martinch14/tecsci_spincoater_hardware_kicad/BOM_listado_Digi_Final.xlsx

Index | Quantity | Part Number | Manufacturer Part Number | Description | Customer Reference | Available | Backorder | Unit Price | Extended Price USD
1 | 1 | 732-5317-ND | 61300411121 | CONN HEADER VERT 4POS 2.54MM |  | 1 | 0 | 0.18 | 0.18
2 | 11 | P10.0KHCT-ND | ERJ-3EKF1002V | RES SMD 10K OHM 1% 1/10W 0603 |  | 11 | 0 | 0.042 | 0.46
3 | 3 | 2N7002NCT-ND | 2N7002 | MOSFET N-CH 60V 115MA SOT-23 |  | 3 | 0 | 0.32 | 0.96
4 | 1 | 1904-1025-1-ND | ESP32-WROOM-32D (16MB) | RX TXRX MOD WIFI TRACE ANT SMD |  | 1 | 0 | 4.5 | 4.50
5 | 1 | SMBJ33A-E3/52GICT-ND | SMBJ33A-E3/52 | TVS DIODE 33V 53.3V DO214AA |  | 1 | 0 | 0.47 | 0.47
6 | 2 | MMSS8050-H-TPMSCT-ND | MMSS8050-H-TP | TRANS NPN 25V 1.5A SOT23 |  | 2 | 0 | 0.18 | 0.36
7 | 1 | 1253-1767-1-ND | MC2016K25.0000C16ESH | XTAL OSC XO 25.0000MHZ CMOS SMD |  | 1 | 0 | 2.37 | 2.37
8 | 1 | 296-47335-1-ND | LMR16020PDDAR | IC REG BUCK ADJUSTABLE 2A 8SOPWR |  | 1 | 0 | 3.38 | 3.38
9 | 1 | 160-2212-1-ND | LTST-C191TBKT-5A | LED BLUE CLEAR CHIP SMD |  | 1 | 0 | 0.48 | 0.48
10 | 2 | AD8418WBRZ-RLCT-ND | AD8418WBRZ-RL | IC CURR SENSE 1 CIRCUIT 8SOIC |  | 2 | 0 | 2.73 | 5.46
11 | 1 | 1460-TMC6100-LA-TCT-ND | TMC6100-LA-T | GATE DRIVER IC 8-60V QFN37 |  | 1 | 0 | 3.13 | 3.13
12 | 2 | 1727-7043-1-ND | 74LVC3G17DC,125 | IC BUF NON-INVERT 5.5V 8VSSOP |  | 2 | 0 | 0.63 | 1.26
13 | 1 | 1460-TMC4671-LA-ND | TMC4671-LA | SERVO CONTROLLER IC, QFN76 |  | 0 | 1 | 12.01 | 12.01
14 | 1 | 336-5890-1-ND | CP2102N-A02-GQFN28R | IC USB TO UART BRIDGE QFN28 |  | 1 | 0 | 1.4 | 1.40
15 | 2 | 401-1704-1-ND | KSR223GLFG | SWITCH TACTILE SPST-NO 0.01A 32V |  | 2 | 0 | 0.84 | 1.68
16 | 1 | P33.0KHCT-ND | ERJ-3EKF3302V | RES SMD 33K OHM 1% 1/10W 0603 |  | 1 | 0 | 0.1 | 0.10
17 | 1 | P270KHCT-ND | ERJ-3EKF2703V | RES SMD 270K OHM 1% 1/10W 0603 |  | 1 | 0 | 0.1 | 0.10
18 | 1 | P47.0KHCT-ND | ERJ-3EKF4702V | RES SMD 47K OHM 1% 1/10W 0603 |  | 1 | 0 | 0.1 | 0.10
19 | 1 | P220KHCT-ND | ERJ-3EKF2203V | RES SMD 220K OHM 1% 1/10W 0603 |  | 1 | 0 | 0.1 | 0.10
20 | 2 | CRE2512-FZ-R005E-3CT-ND | CRE2512-FZ-R005E-3 | RES 0.005 OHM 1% 3W 2512 |  | 2 | 0 | 0.74 | 1.48
21 | 12 | P4.70KHCT-ND | ERJ-3EKF4701V | RES SMD 4.7K OHM 1% 1/10W 0603 |  | 12 | 0 | 0.049 | 0.59
22 | 2 | 311-1.0KARCT-ND | RC0805JR-071KL | RES SMD 1K OHM 5% 1/8W 0805 |  | 2 | 0 | 0.1 | 0.20
23 | 2 | P10KACT-ND | ERJ-6GEYJ103V | RES SMD 10K OHM 5% 1/8W 0805 |  | 2 | 0 | 0.1 | 0.20
24 | 1 | 1276-5544-1-ND | RC2012J472CS | RES SMD 4.7K OHM 5% 1/8W 0805 |  | 1 | 0 | 0.14 | 0.14
25 | 3 | SI7938DP-T1-GE3CT-ND | SI7938DP-T1-GE3 | MOSFET 2N-CH 40V 60A PPAK SO-8 |  | 3 | 0 | 1.48 | 4.44
26 | 2 | 732-1593-1-ND | 742792651 | FERRITE BEAD 600 OHM 0603 1LN |  | 2 | 0 | 0.17 | 0.34
27 | 1 | 445-173041-1-ND | VLS6045EX-150M | FIXED IND 15UH 2.5A 98 MOHM SMD |  | 1 | 0 | 0.51 | 0.51
28 | 3 | 490-13269-1-ND | BLM31SN500SN1L | FERRITE BEAD 50 OHM 1206 1LN |  | 3 | 0 | 0.35 | 1.05
29 | 1 | 277-1106-ND | 1757242 | TERM BLOCK HDR 2POS 90DEG 5.08MM |  | 1 | 0 | 0.64 | 0.64
30 | 1 | 277-1207-ND | 1803280 | TERM BLOCK HDR 3POS 90DEG 3.81MM |  | 1 | 0 | 1.26 | 1.26
31 | 2 | 732-5318-ND | 61300511121 | CONN HEADER VERT 5POS 2.54MM |  | 2 | 0 | 0.25 | 0.50
32 | 2 | 732-5315-ND | 61300211121 | CONN HEADER VERT 2POS 2.54MM |  | 2 | 0 | 0.13 | 0.26
33 | 1 | WM1399CT-ND | 1050170001 | CONN RCPT USB2.0 MICRO B SMD R/A |  | 1 | 0 | 0.91 | 0.91
34 | 1 | V2PM10HM3/HGICT-ND | V2PM10HM3/H | DIODE SCHOTTKY 100V 2A MICROSMP |  | 1 | 0 | 0.34 | 0.34
35 | 1 | 1727-3873-1-ND | PMEG3020EH,115 | DIODE SCHOTTKY 30V 2A SOD123F |  | 1 | 0 | 0.44 | 0.44
36 | 2 | 587-3169-1-ND | UMK212BB7225KG-T | CAP CER 2.2UF 50V X7R 0805 |  | 2 | 0 | 0.38 | 0.76
37 | 1 | 399-7841-1-ND | C0603C103K4RACTU | CAP CER 10000PF 16V X7R 0603 |  | 1 | 0 | 0.1 | 0.10
38 | 3 | 399-11629-1-ND | C1210C106K5RACTU | CAP CER 10UF 50V X7R 1210 |  | 3 | 0 | 0.86 | 2.58
39 | 2 | 399-1085-1-ND | C0603C222K5RACTU | CAP CER 2200PF 50V X7R 0603 |  | 2 | 0 | 0.1 | 0.20
40 | 1 | 399-3476-1-ND | C0603C223K1RACTU | CAP CER 0.022UF 100V X7R 0603 |  | 1 | 0 | 0.1 | 0.10
41 | 4 | 587-3170-1-ND | UMK107B7474KA-TR | CAP CER 0.47UF 50V X7R 0603 |  | 4 | 0 | 0.19 | 0.76
42 | 2 | 587-5835-1-ND | EMK107BB7225KA-T | CAP CER 2.2UF 16V X7R 0603 |  | 2 | 0 | 0.33 | 0.66
43 | 2 | 490-10743-1-ND | GRM219R61H105KA73D | CAP CER 1UF 50V X5R 0805 |  | 2 | 0 | 0.25 | 0.50
44 | 2 | 399-7415-1-ND | C0805C475K4RACTU | CAP CER 4.7UF 16V X7R 0805 |  | 2 | 0 | 0.25 | 0.50
45 | 1 | 1276-6504-1-ND | CL10A226MPCNUBE | CAP CER 22UF 10V X5R 0603 |  | 1 | 0 | 0.36 | 0.36
46 | 1 | 277-1162-ND | 1803581 | TERM BLOCK PLUG 3POS STR 3.81MM |  | 1 | 0 | 3.58 | 3.58
47 | 1 | 277-1011-ND | 1757019 | TERM BLOCK PLUG 2POS STR 5.08MM |  | 1 | 0 | 1.99 | 1.99
48 | 10 | A129686CT-ND | CRGCQ0603F680R | CRGCQ 0603 680R 1% |  | 10 | 0 | 0.028 | 0.28
49 | 10 | A129718CT-ND | CRGCQ0603F330K | CRGCQ 0603 330K 1% |  | 10 | 0 | 0.028 | 0.28
50 | 50 | 399-7845-1-ND | C0603C104M5RACTU | CAP CER 0.1UF 50V X7R 0603 |  | 50 | 0 | 0.0204 | 1.02
51 | 10 | P1.00KHCT-ND | ERJ-3EKF1001V | RES SMD 1K OHM 1% 1/10W 0603 |  | 10 | 0 | 0.04 | 0.40
52 | 6 | P10.0HCT-ND | ERJ-3EKF10R0V | RES SMD 10 OHM 1% 1/10W 0603 |  | 6 | 0 | 0.1 | 0.60
53 | 10 | 399-7831-1-ND | C0603C102K1RACTU | CAP CER 1000PF 100V X7R 0603 |  | 10 | 0 | 0.067 | 0.67
54 | 10 | 490-6473-1-ND | GRM21BR61C106KE15K | CAP CER 10UF 16V X5R 0805 |  | 10 | 0 | 0.182 | 1.82
55 | 2 | LP2985AIM5-3.3/NOPBCT-ND | LP2985AIM5-3.3/NOPB | IC REG LINEAR 3.3V 150MA SOT23-5 |  | 2 | 0 | 0.86 | 1.72
