martinch14/tecsci_spincoater_hardware_kicad/Models3D/LTST-C191TBKT-5A--3DModel-STEP-56544.STEP

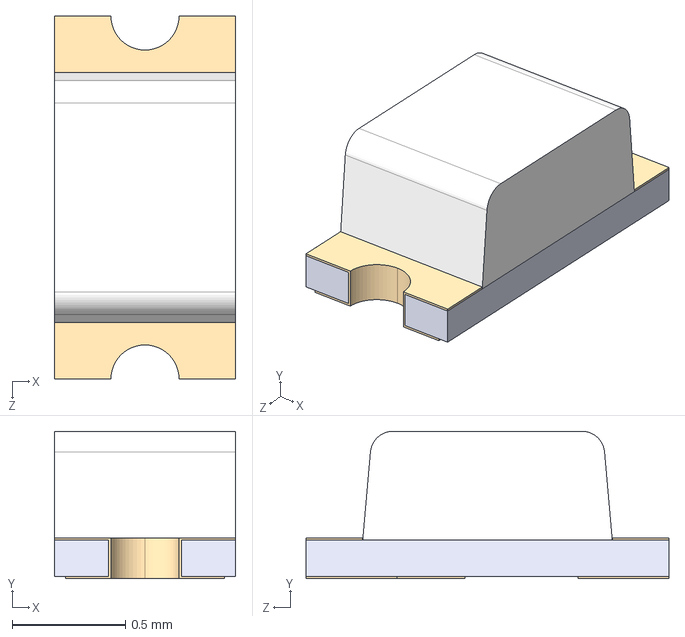
[picture p1: CAD file, 2020-06-23]
Models3D/LTST-C191TBKT-5A--3DModel-STEP-56544.STEP
0.8 x 0.65 x 1.60 mm
