martinch14/tecsci_spincoater_hardware_kicad/Models3D/vls6045ex.step

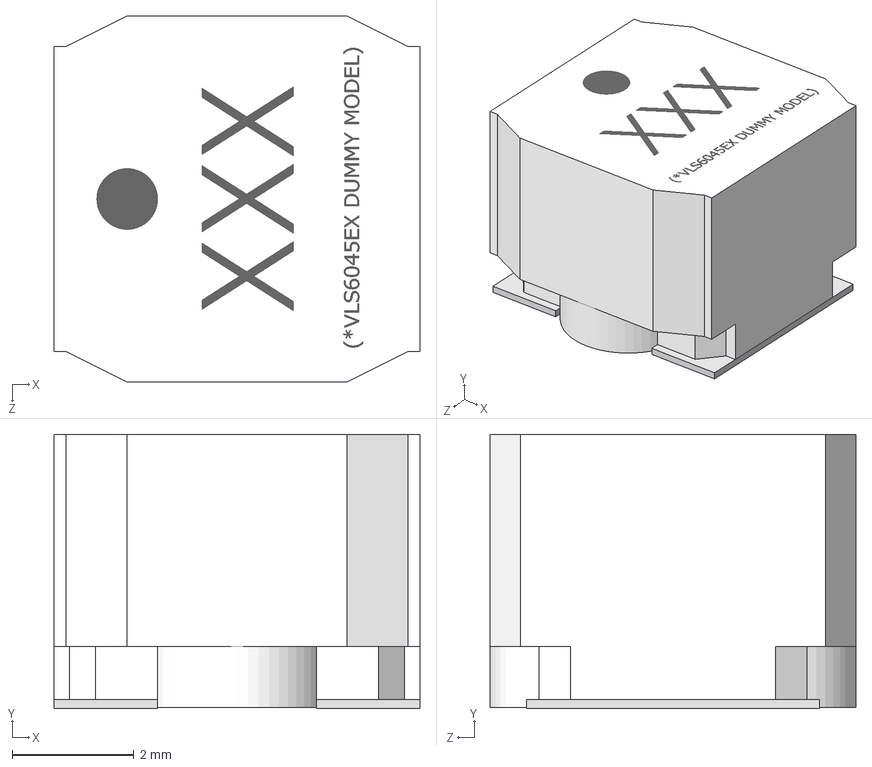
[picture p2: CAD file, 2020-06-23]
Models3D/vls6045ex.step
6.00 x 4.50 x 6.00 mm
VLS6045EX_C(3Dmodel)
VLS6045EX_T(3Dmodel)
