martinch14/tecsci_spincoater_hardware_kicad/Fabricado/spincoater.pdf

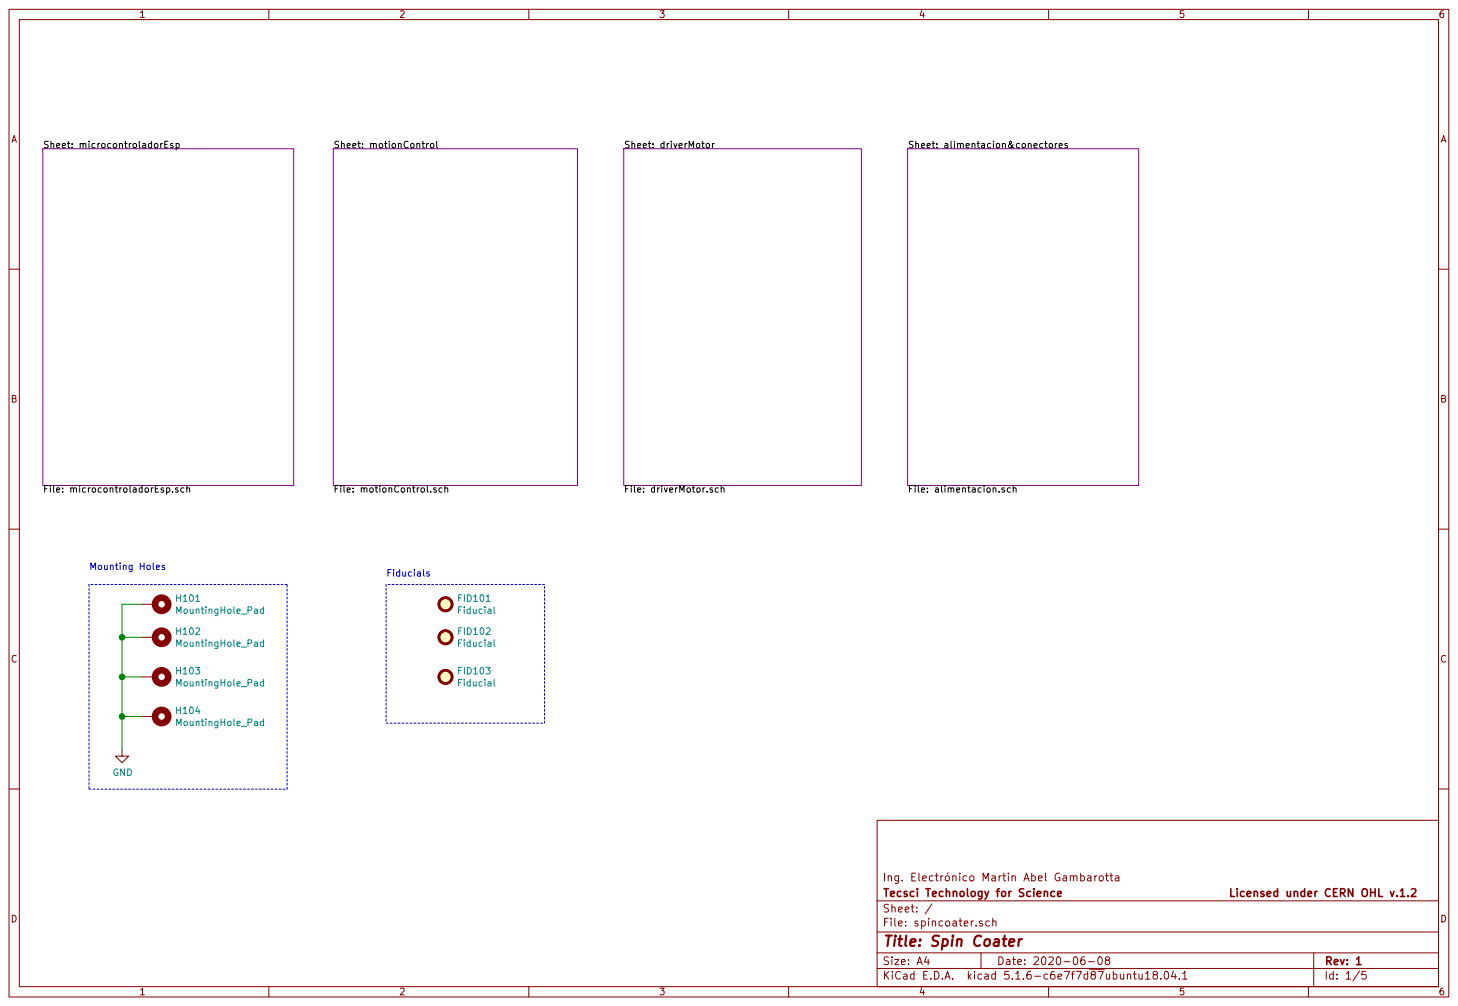
[picture p3: page 1]

Ing. Electrónico Martin Abel Gambarotta

Id: 1/5 Title: Spin Coater

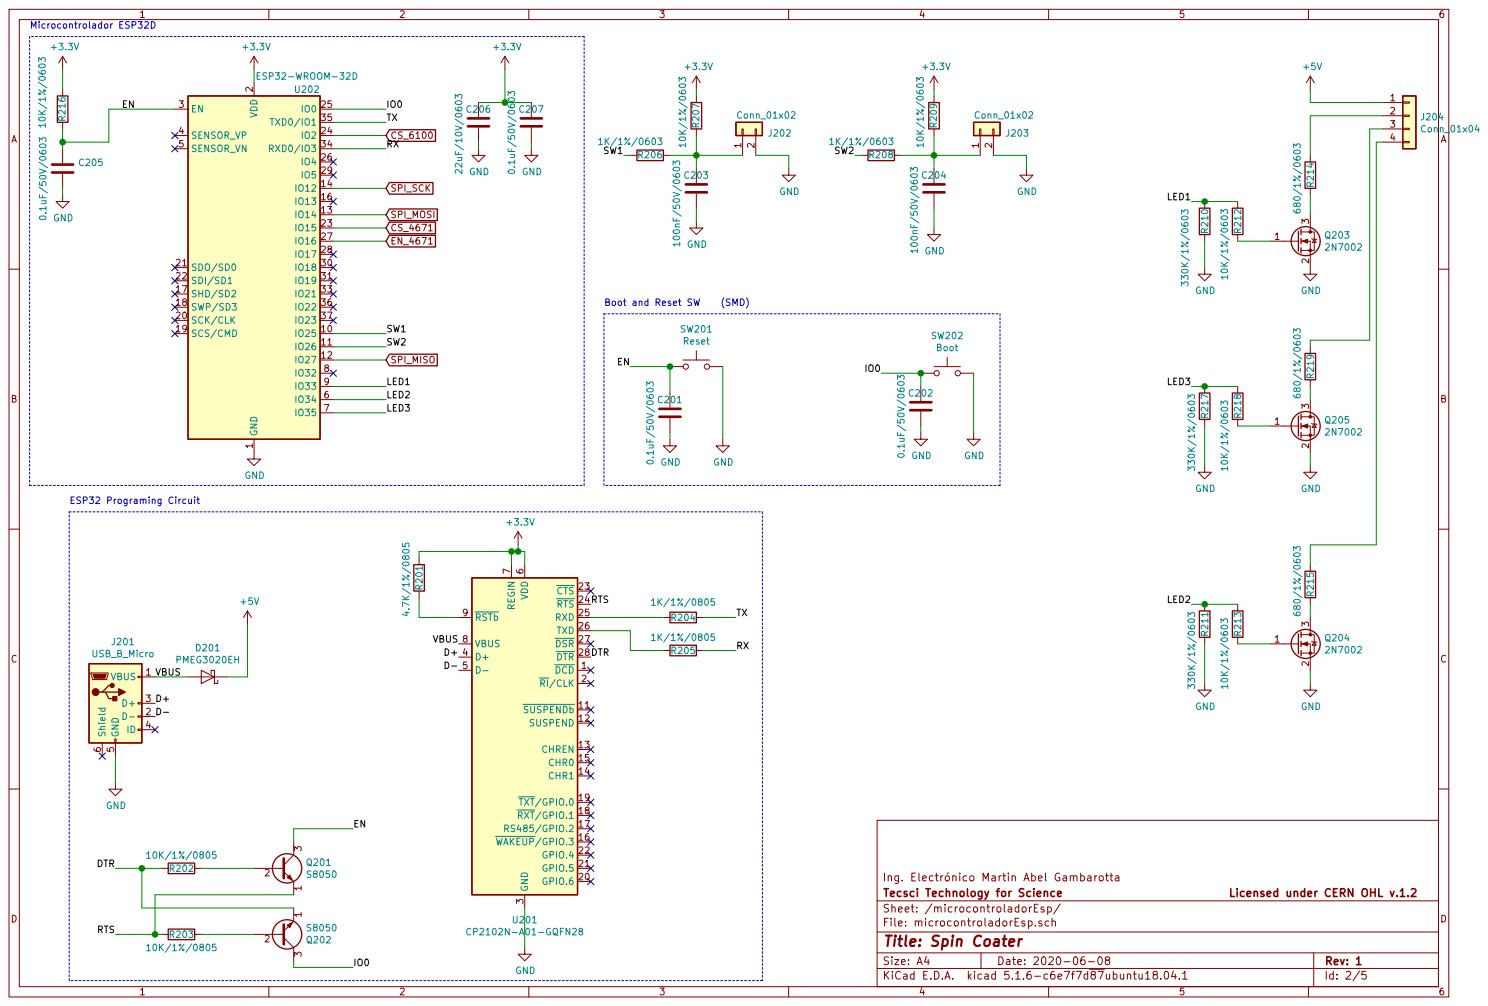
[picture p4: page 2]

2 SCK/CLK 20 SDO/SD0 21 SDI/SD1 22

Boot and Reset SW (SMD)

3 Q202 S8050 DCD 1 SUSPENDb 11 SUSPEND 12 CHREN 13 CHR1 14 CHR0 15 WAKEUP/GPIO.3 16 RS485/GPIO.2 17 RXT/GPIO.1 18 TXT/GPIO.0 19 RI/CLK 2 GPIO.6 20 GPIO.5 21 GPIO.4 22 CTS 23 RTS 24 RXD 25 TXD 26 DSR 27 DTR 28 GND

Ing. Electrónico Martin Abel Gambarotta
Sheet: /microcontroladorEsp/
File: microcontroladorEsp.sch
Id: 2/5 Title: Spin Coater

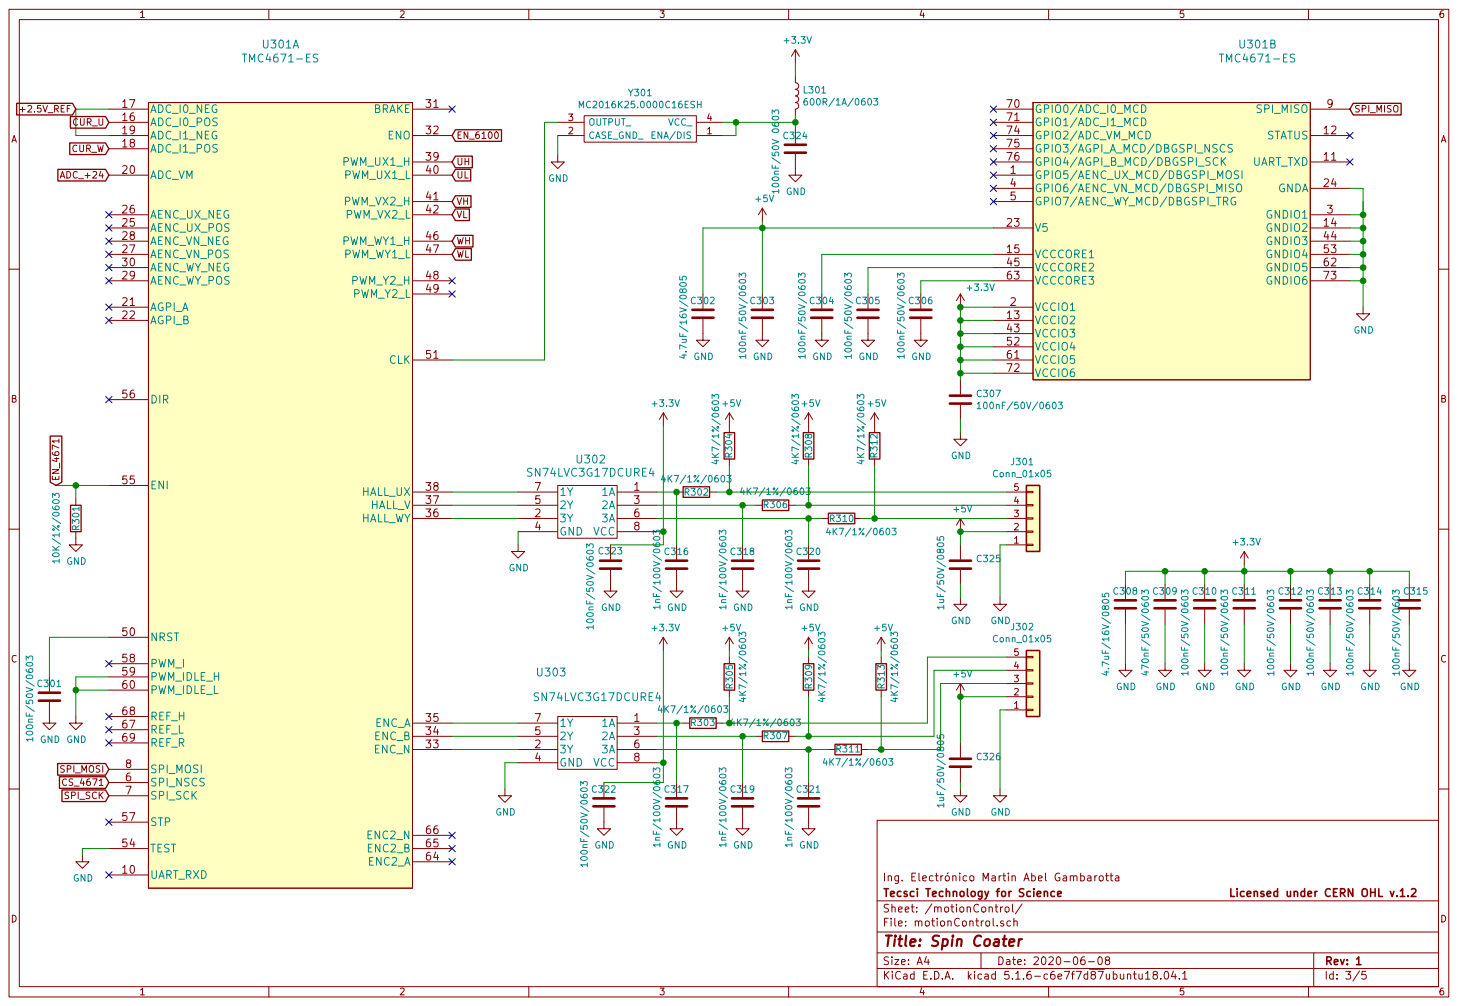
[picture p5: page 3]

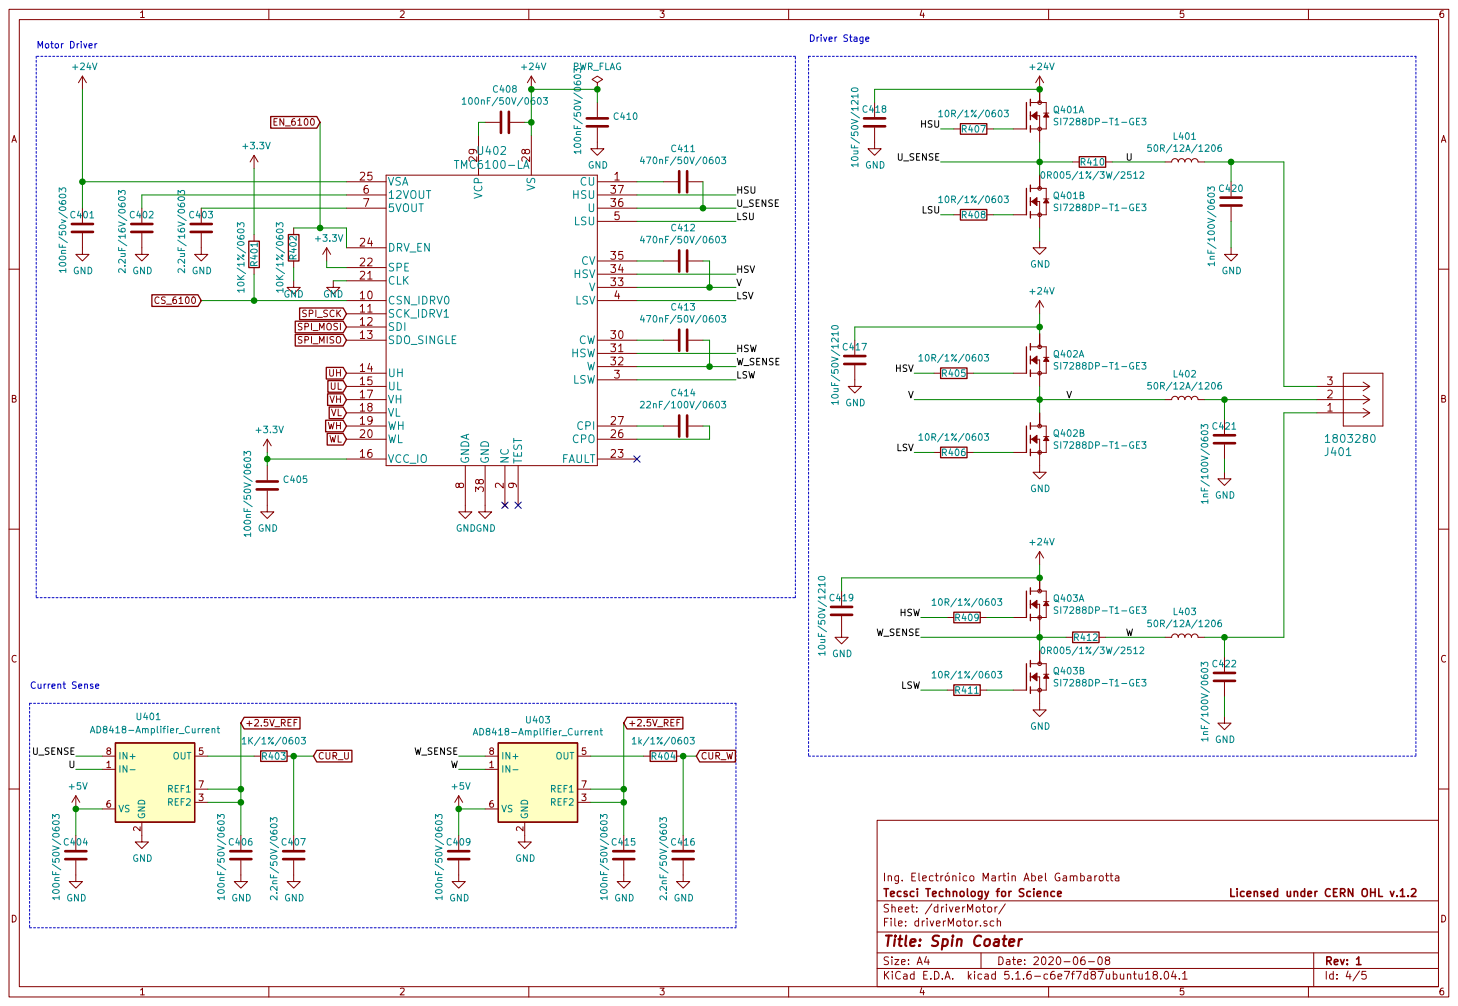
[picture p6: page 4]

Driver Stage Motor Driver
470nF/50V/0603 GND

2 WL 20 CLK 21 SPE 22 FAULT 23 DRV_EN 24 VSA 25 CPO 26 CPI 27 VS 28 VCP 29

LSV HSU W_SENSE U_SENSE Current Sense

Ing. Electrónico Martin Abel Gambarotta

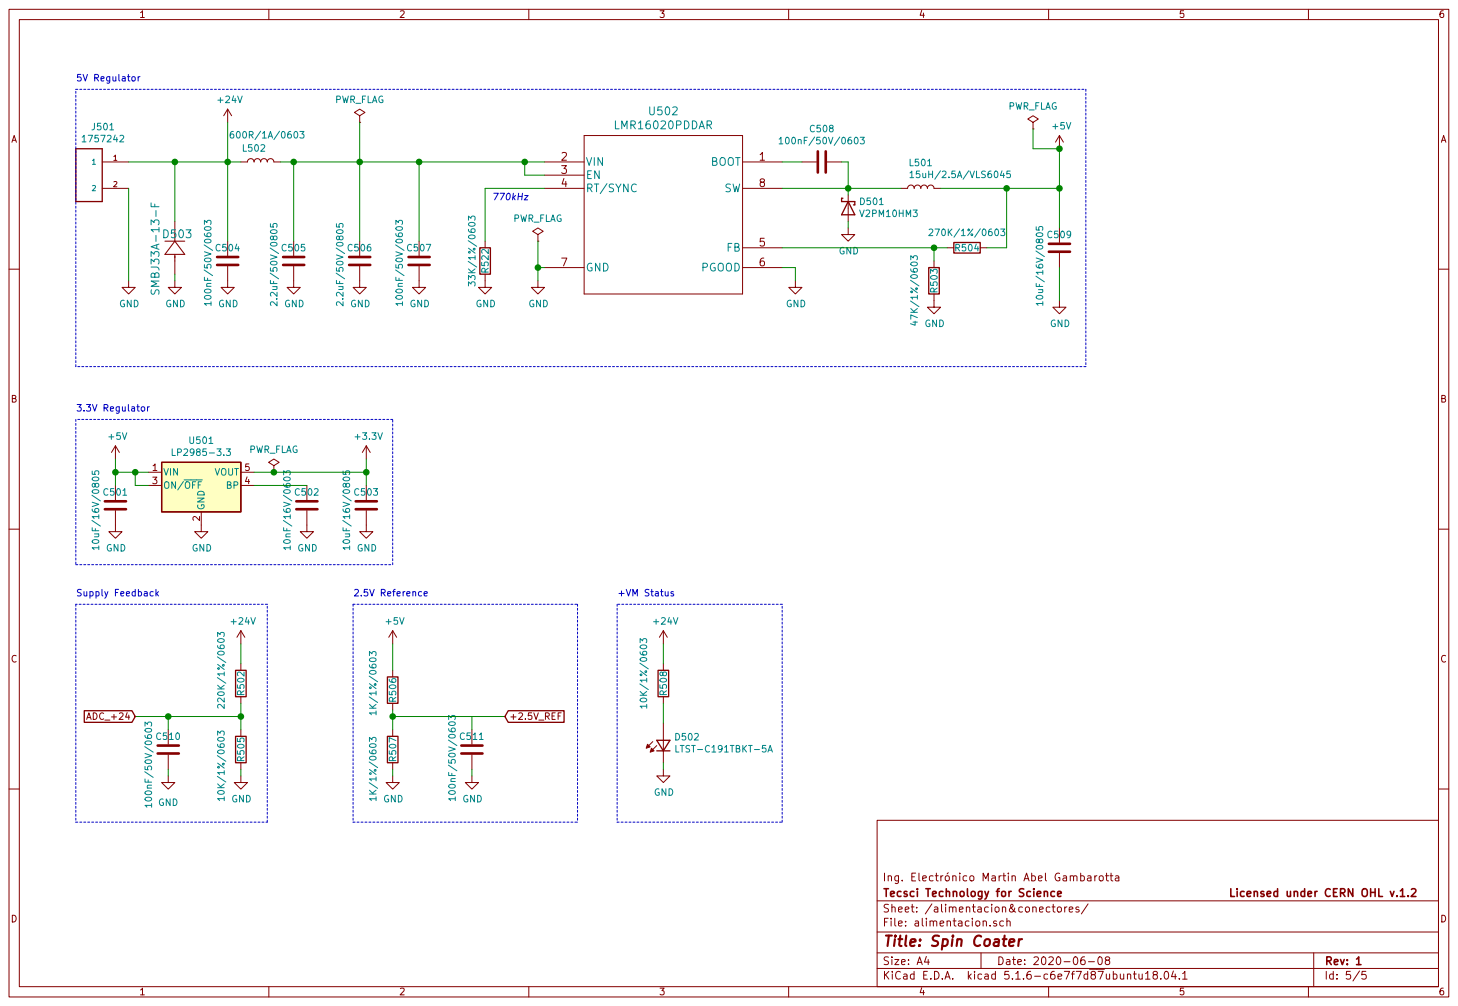
[picture p7: page 5]

2 ON/OFF 3 BP 4 VOUT 5 U501

Ing. Electrónico Martin Abel Gambarotta
