martinch14/tecsci_spincoater_hardware_kicad/spincoater.kicad_pcb

## KiCad design spincoater.kicad_pcb (2020-07-17)

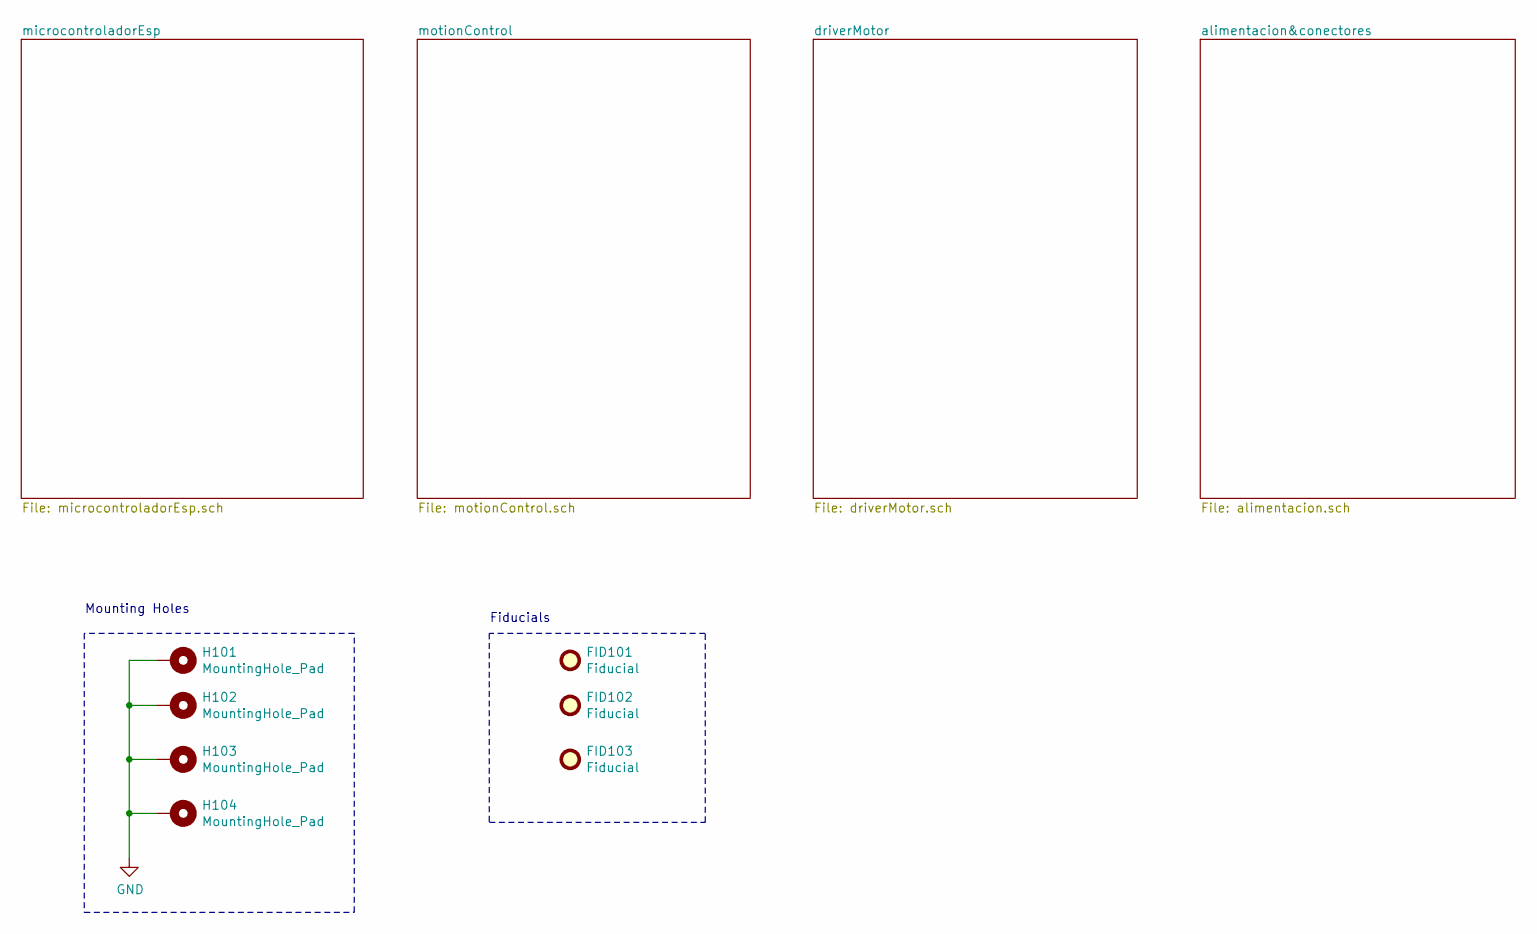
[picture p8: schematic spincoater.sch, Spin Coater]

Parts:
FID101, FID102, FID103: Fiducial; Fiducial_0.5mm_Mask1mm
H101, H102, H103, H104: MountingHole_Pad; MountingHole_3.2mm_M3_Pad_Via

Connections:
GND: H101.1, H102.1, H103.1, H104.1; also elsewhere on the board

Notes on the sheet:
Mounting Holes
Fiducials

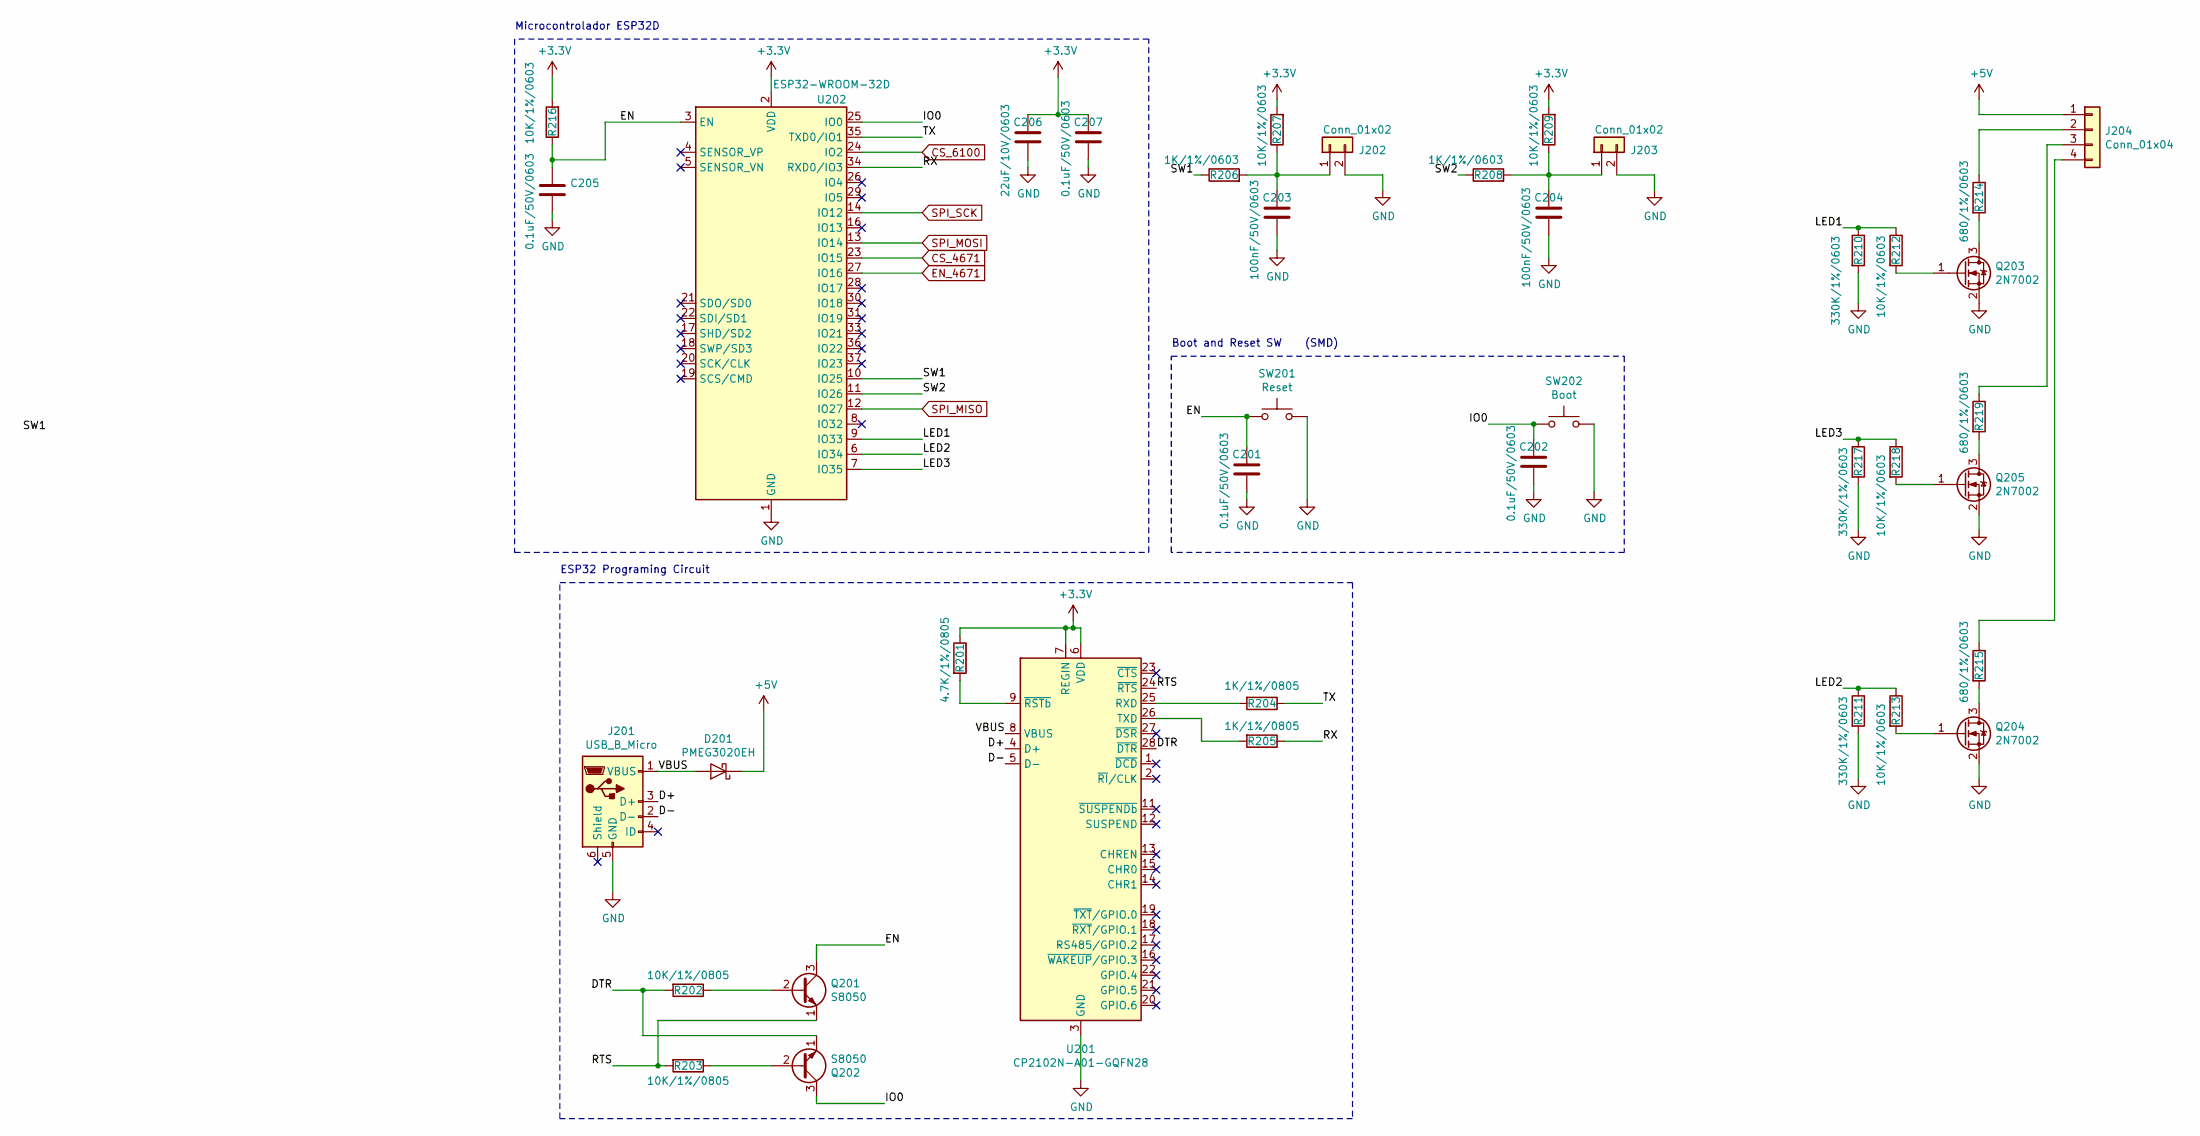
[picture p9: schematic microcontroladorEsp.sch, Spin Coater]

Parts:
C201, C202, C205, C207: 0.1uF/50V/0603; C_0603_1608Metric
C203, C204: 100nF/50V/0603; C_0603_1608Metric
C206: 22uF/10V/0603; C_0603_1608Metric
D201: PMEG3020EH; D_SOD-123F
J201: USB_B_Micro; USB_Micro-B_Molex-105017-0001
J202, J203: Conn_01x02; PinHeader_1x02_P2.54mm_Vertical
J204: Conn_01x04; PinHeader_1x04_P2.54mm_Vertical
Q201, Q202: S8050; SOT-23
Q203, Q204, Q205: 2N7002; SOT-23
R201: 4.7K/1%/0805; R_0805_2012Metric
R202, R203: 10K/1%/0805; R_0805_2012Metric
R204, R205: 1K/1%/0805; R_0805_2012Metric
R206, R208: 1K/1%/0603; R_0603_1608Metric
R207, R209, R212, R213, R216, R218: 10K/1%/0603; R_0603_1608Metric
R210, R211, R217: 330K/1%/0603; R_0603_1608Metric
R214, R215, R219: 680/1%/0603; R_0603_1608Metric
SW201: Reset; KSR223GLFG
SW202: Boot; KSR223GLFG
U201: CP2102N-A01-GQFN28; QFN-28-1EP_5x5mm_P0.5mm_EP3.35x3.35mm
U202: ESP32-WROOM-32D; ESP32-WROOM-32

Connections:
+3V3: C206.1, C207.1, R201.1, R207.2, R209.2, R216.2, U201.6 (VDD), U201.7 (REGIN), U202.2 (VDD); also elsewhere on the board
+5V: D201.1 (K), J204.1; also elsewhere on the board
/microcontroladorEsp/D+: J201.3 (D+), U201.4 (D+)
/microcontroladorEsp/D-: J201.2 (D-), U201.5 (D-)
/microcontroladorEsp/DTR: Q202.1 (E), R202.2, U201.28 (~DTR)
/microcontroladorEsp/EN: C201.1, C205.1, Q201.3 (C), R216.1, SW201.1, U202.3 (EN)
/microcontroladorEsp/IO0: C202.1, Q202.3 (C), SW202.1, U202.25 (IO0)
/microcontroladorEsp/LED1: R210.1, R212.1, U202.9 (IO33)
/microcontroladorEsp/LED2: R211.1, R213.1, U202.6 (IO34)
/microcontroladorEsp/LED3: R217.1, R218.1, U202.7 (IO35)
/microcontroladorEsp/RTS: Q201.1 (E), R203.2, U201.24 (~RTS)
/microcontroladorEsp/RX: R205.1, U202.34 (RXD0/IO3)
/microcontroladorEsp/SW1: R206.1, U202.10 (IO25)
/microcontroladorEsp/SW2: R208.1, U202.11 (IO26)
/microcontroladorEsp/TX: R204.1, U202.35 (TXD0/IO1)
/microcontroladorEsp/VBUS: D201.2 (A), J201.1 (VBUS), U201.8 (VBUS)
CS_4671: U202.23 (IO15); also elsewhere on the board
CS_6100: U202.24 (IO2); also elsewhere on the board
EN_4671: U202.27 (IO16); also elsewhere on the board
GND: C201.2, C202.2, C203.2, C204.2, C205.2, C206.2, C207.2, J201.5 (GND), J202.2, J203.2, Q203.2 (S), Q204.2 (S), Q205.2 (S), R210.2, R211.2, R217.2, SW201.2, SW202.2, U201.3 (GND), U201.29 (GND), U202.1 (GND), U202.15 (GND), U202.38 (GND), U202.39 (GND); also elsewhere on the board
unnamed: C203.1, J202.1, R206.2, R207.1
unnamed: C204.1, J203.1, R208.2, R209.1
unnamed: J204.2, R214.1
unnamed: J204.3, R219.1
unnamed: J204.4, R215.1
unnamed: Q201.2 (B), R202.1
unnamed: Q202.2 (B), R203.1
unnamed: Q203.1 (G), R212.2
unnamed: Q203.3 (D), R214.2
unnamed: Q204.1 (G), R213.2
unnamed: Q204.3 (D), R215.2
unnamed: Q205.1 (G), R218.2
unnamed: Q205.3 (D), R219.2
unnamed: R201.2, U201.9 (~RSTb)
unnamed: R204.2, U201.25 (RXD)
unnamed: R205.2, U201.26 (TXD)
SPI_MISO: U202.12 (IO27); also elsewhere on the board
SPI_MOSI: U202.13 (IO14); also elsewhere on the board
SPI_SCK: U202.14 (IO12); also elsewhere on the board

Notes on the sheet:
ESP32 Programing Circuit
Boot and Reset SW (SMD)
Microcontrolador ESP32D

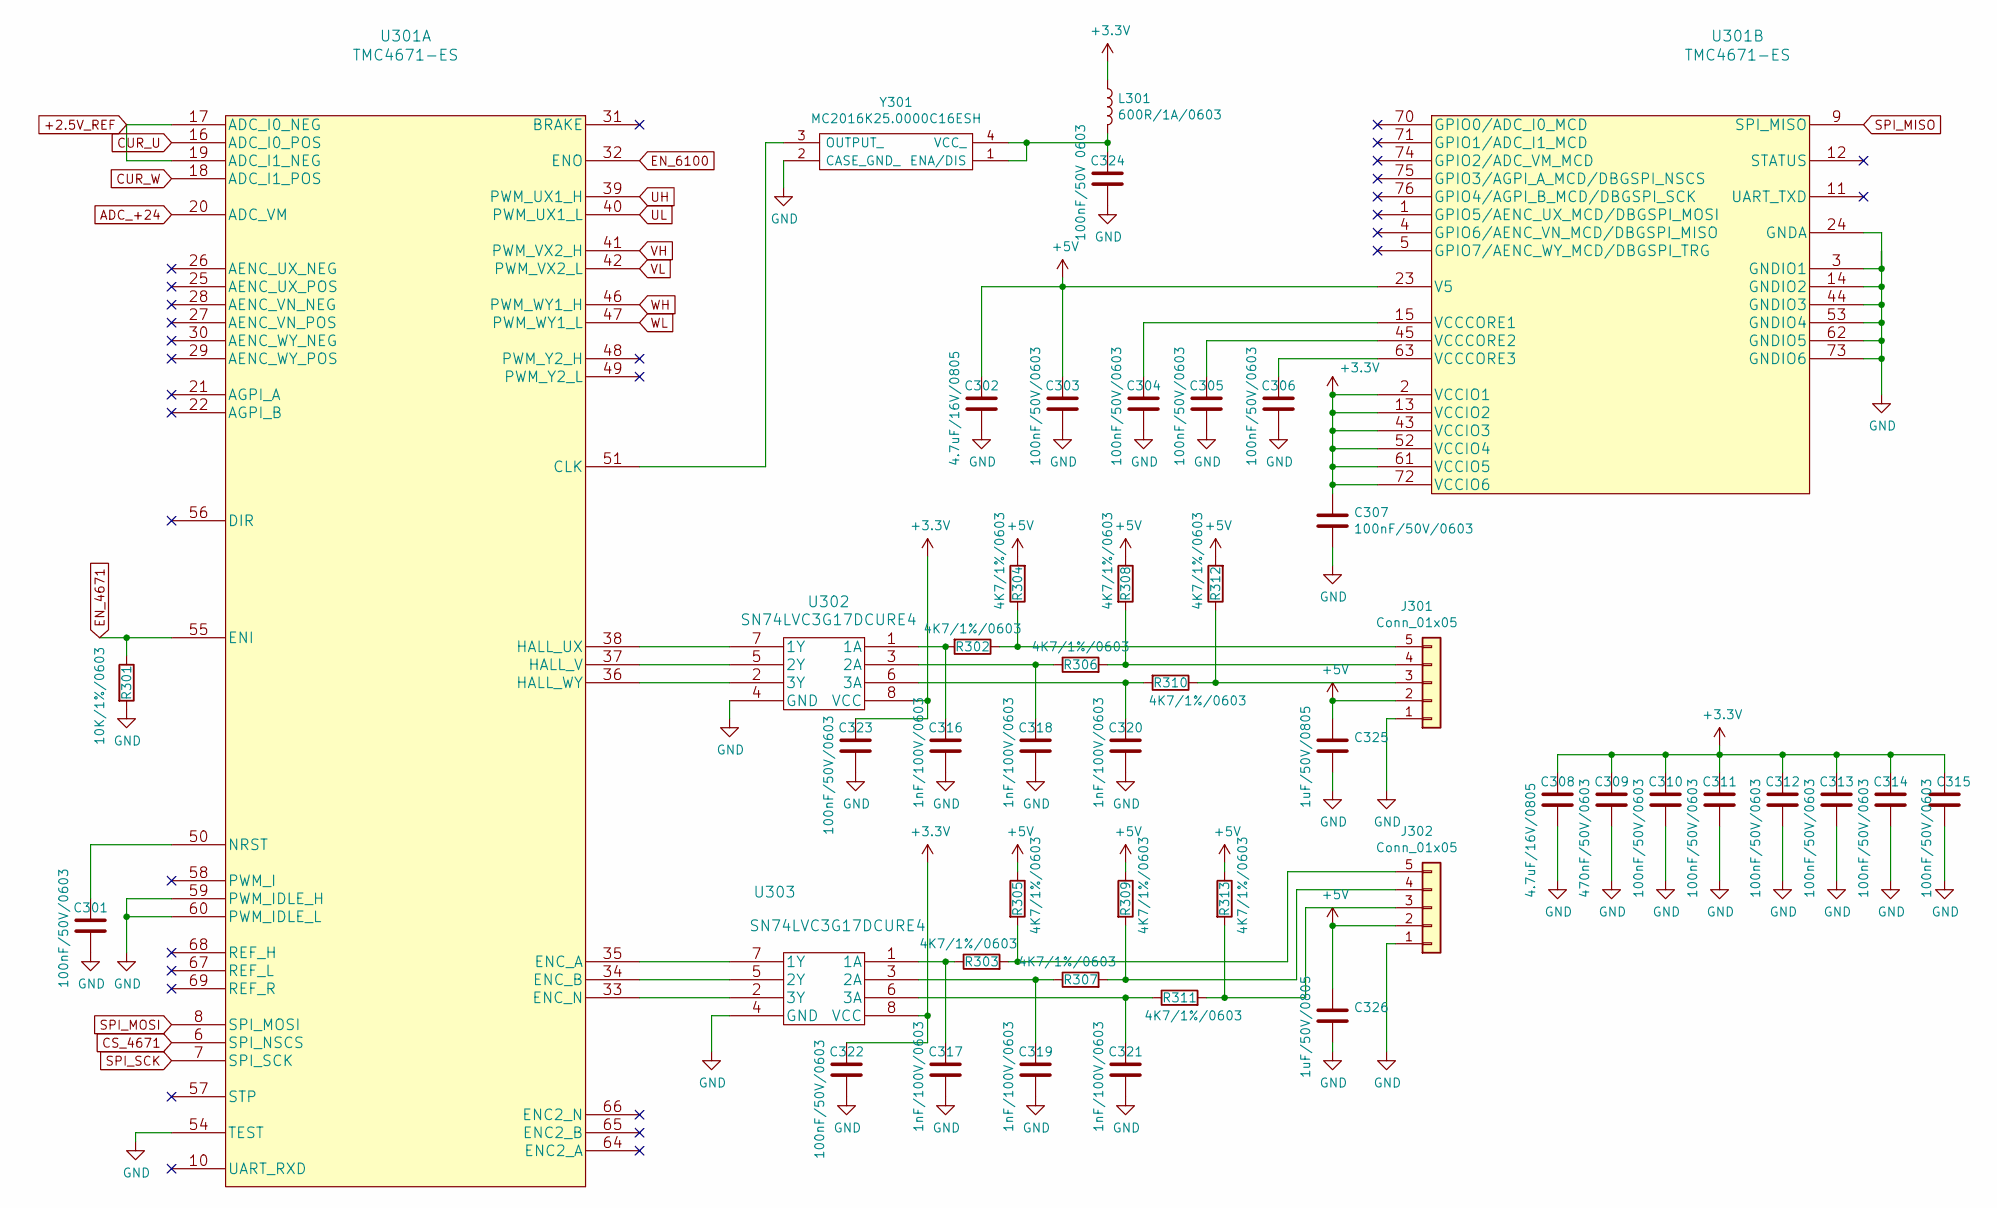
[picture p10: schematic motionControl.sch, Spin Coater]

Parts:
C301, C303, C304, C305, C306, C307, C310, C311, C312, C313, C314, C315, C322, C323: 100nF/50V/0603; C_0603_1608Metric
C302, C308: 4.7uF/16V/0805; C_0805_2012Metric
C309: 470nF/50V/0603; C_0603_1608Metric
C316, C317, C318, C319, C320, C321: 1nF/100V/0603; C_0603_1608Metric
C324: 100nF/50V 0603; C_0603_1608Metric
C325, C326: 1uF/50V/0805; C_0805_2012Metric
J301, J302: Conn_01x05; PinHeader_1x05_P2.54mm_Vertical
L301: 600R/1A/0603; L_0603_1608Metric
R301: 10K/1%/0603; R_0603_1608Metric
R302, R303, R304, R305, R306, R307, R308, R309, R310, R311, R312, R313: 4K7/1%/0603; R_0603_1608Metric
U301: TMC4671-ES; TMC4671-LA
U302, U303: SN74LVC3G17DCURE4
Y301: MC2016K25.0000C16ESH; MC2016K250000C16ESH; Manufacturer_Part_Number MC2016K25.0000C16ESH

Connections:
+2.5V_REF: U301.17 (ADC_I0_NEG), U301.19 (ADC_I1_NEG); also elsewhere on the board
+3V3: C307.1, C308.1, C309.1, C310.1, C311.1, C312.1, C313.1, C314.1, C315.1, C322.1, C323.2, L301.1, U301.2 (VCCIO1), U301.13 (VCCIO2), U301.43 (VCCIO3), U301.52 (VCCIO4), U301.61 (VCCIO5), U301.72 (VCCIO6), U302.8 (VCC), U303.8 (VCC); also elsewhere on the board
+5V: C302.1, C303.1, C325.1, C326.1, J301.2, J302.2, R304.2, R305.1, R308.1, R309.1, R312.2, R313.1, U301.23 (V5); also elsewhere on the board
ADC_+24: U301.20 (ADC_VM); also elsewhere on the board
CS_4671: U301.6 (SPI_NSCS); also elsewhere on the board
CUR_U: U301.16 (ADC_I0_POS); also elsewhere on the board
CUR_W: U301.18 (ADC_I1_POS); also elsewhere on the board
EN_4671: R301.1, U301.55 (ENI); also elsewhere on the board
EN_6100: U301.32 (ENO); also elsewhere on the board
GND: C301.2, C302.2, C303.2, C304.2, C305.2, C306.2, C307.2, C308.2, C309.2, C310.2, C311.2, C312.2, C313.2, C314.2, C315.2, C316.2, C317.2, C318.2, C319.2, C320.2, C321.2, C322.2, C323.1, C324.2, C325.2, C326.2, J301.1, J302.1, R301.2, U301.3 (GNDIO1), U301.14 (GNDIO2), U301.24 (GNDA), U301.44 (GNDIO3), U301.53 (GNDIO4), U301.54 (TEST), U301.59 (PWM_IDLE_H), U301.60 (PWM_IDLE_L), U301.62 (GNDIO5), U301.73 (GNDIO6), U302.4 (GND), U303.4 (GND), Y301.2 (CASE_GND_); also elsewhere on the board
unnamed: C301.1, U301.50 (NRST)
unnamed: C304.1, U301.15 (VCCCORE1)
unnamed: C305.1, U301.45 (VCCCORE2)
unnamed: C306.1, U301.63 (VCCCORE3)
unnamed: C316.1, R302.2, U302.1 (1A)
unnamed: C317.1, R303.1, U303.1 (1A)
unnamed: C318.1, R306.1, U302.3 (2A)
unnamed: C319.1, R307.1, U303.3 (2A)
unnamed: C320.1, R310.2, U302.6 (3A)
unnamed: C321.1, R311.1, U303.6 (3A)
unnamed: C324.1, L301.2, Y301.1 (ENA/DIS), Y301.4 (VCC_)
unnamed: J301.3, R310.1, R312.1
unnamed: J301.4, R306.2, R308.2
unnamed: J301.5, R302.1, R304.1
unnamed: J302.3, R311.2, R313.2
unnamed: J302.4, R307.2, R309.2
unnamed: J302.5, R303.2, R305.2
unnamed: U301.33 (ENC_N), U303.2 (3Y)
unnamed: U301.34 (ENC_B), U303.5 (2Y)
unnamed: U301.35 (ENC_A), U303.7 (1Y)
unnamed: U301.36 (HALL_WY), U302.2 (3Y)
unnamed: U301.37 (HALL_V), U302.5 (2Y)
unnamed: U301.38 (HALL_UX), U302.7 (1Y)
unnamed: U301.51 (CLK), Y301.3 (OUTPUT_)
SPI_MISO: U301.9 (SPI_MISO); also elsewhere on the board
SPI_MOSI: U301.8 (SPI_MOSI); also elsewhere on the board
SPI_SCK: U301.7 (SPI_SCK); also elsewhere on the board
UH: U301.39 (PWM_UX1_H); also elsewhere on the board
UL: U301.40 (PWM_UX1_L); also elsewhere on the board
VH: U301.41 (PWM_VX2_H); also elsewhere on the board
VL: U301.42 (PWM_VX2_L); also elsewhere on the board
WH: U301.46 (PWM_WY1_H); also elsewhere on the board
WL: U301.47 (PWM_WY1_L); also elsewhere on the board

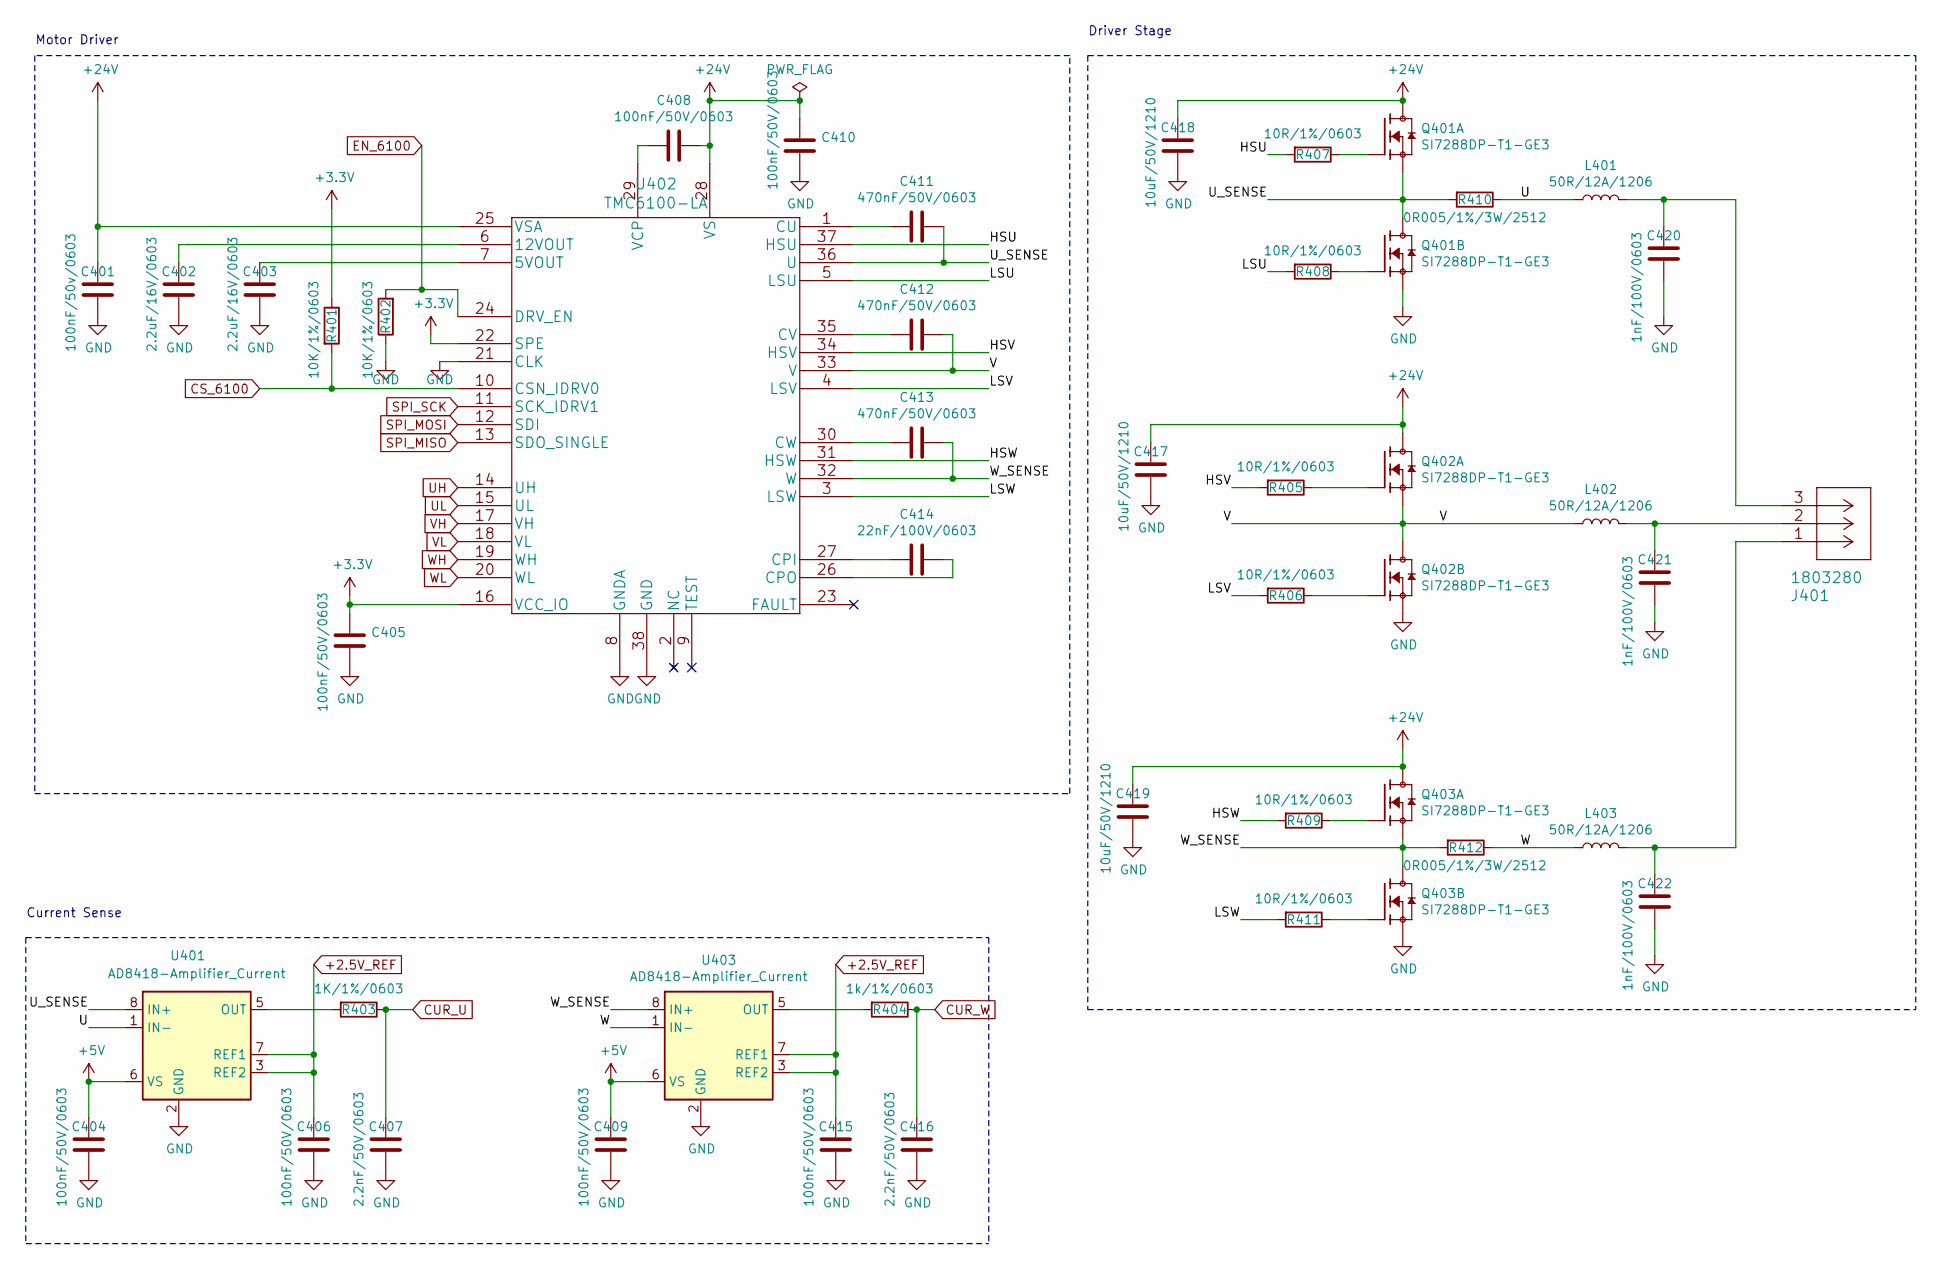
[picture p11: schematic driverMotor.sch, Spin Coater]

Parts:
C401: 100nF/50v/0603; C_0603_1608Metric
C402, C403: 2.2uF/16V/0603; C_0603_1608Metric
C404, C405, C406, C408, C409, C410, C415: 100nF/50V/0603; C_0603_1608Metric
C407, C416: 2.2nF/50V/0603; C_0603_1608Metric
C411, C412, C413: 470nF/50V/0603; C_0603_1608Metric
C414: 22nF/100V/0603; C_0603_1608Metric
C417, C418, C419: 10uF/50V/1210; C_1210_3225Metric
C420, C421, C422: 1nF/100V/0603; C_0603_1608Metric
J401: 1803280
L401, L402, L403: 50R/12A/1206; L_1206_3216Metric
Q401, Q402, Q403: SI7288DP-T1-GE3; TRANS_SI7288DP-T1-GE3
R401, R402: 10K/1%/0603; R_0603_1608Metric
R403: 1K/1%/0603; R_0603_1608Metric
R404: 1k/1%/0603; R_0603_1608Metric
R405, R406, R407, R408, R409, R411: 10R/1%/0603; R_0603_1608Metric
R410, R412: 0R005/1%/3W/2512; R_2512_6332Metric
U401, U403: AD8418-Amplifier_Current; AD8418WBRZ-RL
U402: TMC6100-LA

Connections:
+2.5V_REF: C406.1, C415.1, U401.3 (REF2), U401.7 (REF1), U403.3 (REF2), U403.7 (REF1); also elsewhere on the board
+3V3: C405.1, R401.1, U402.16 (VCC_IO), U402.22 (SPE); also elsewhere on the board
+5V: C404.1, C409.1, U401.6 (VS), U403.6 (VS); also elsewhere on the board
+24V: C401.1, C408.1, C410.1, C417.1, C418.1, C419.1, Q401.7, Q401.8, Q401.9, Q402.7, Q402.8, Q402.9, Q403.7, Q403.8, Q403.9, U402.25 (VSA), U402.28 (VS); also elsewhere on the board
/driverMotor/HSU: R407.2, U402.37 (HSU)
/driverMotor/HSV: R405.2, U402.34 (HSV)
/driverMotor/HSW: R409.2, U402.31 (HSW)
/driverMotor/LSU: R408.2, U402.5 (LSU)
/driverMotor/LSV: R406.2, U402.4 (LSV)
/driverMotor/LSW: R411.2, U402.3 (LSW)
/driverMotor/U: L401.1, R410.1, U401.1 (IN-)
/driverMotor/U_SENSE: C411.1, Q401.1, Q401.5, Q401.6, Q401.10, R410.2, U401.8 (IN+), U402.36 (U)
/driverMotor/V: C412.1, L402.1, Q402.1, Q402.5, Q402.6, Q402.10, U402.33 (V)
/driverMotor/W: L403.1, R412.1, U403.1 (IN-)
/driverMotor/W_SENSE: C413.1, Q403.1, Q403.5, Q403.6, Q403.10, R412.2, U402.32 (W), U403.8 (IN+)
CS_6100: R401.2, U402.10 (CSN_IDRV0); also elsewhere on the board
CUR_U: C407.1, R403.1; also elsewhere on the board
CUR_W: C416.1, R404.1; also elsewhere on the board
EN_6100: R402.2, U402.24 (DRV_EN); also elsewhere on the board
GND: C401.2, C402.2, C403.2, C404.2, C405.2, C406.2, C407.2, C409.2, C410.2, C415.2, C416.2, C417.2, C418.2, C419.2, C420.2, C421.2, C422.2, Q401.3, Q402.3, Q403.3, R402.1, U401.2 (GND), U402.8 (GNDA), U402.21 (CLK), U402.38 (GND), U403.2 (GND); also elsewhere on the board
unnamed: C402.1, U402.6 (12VOUT)
unnamed: C403.1, U402.7 (5VOUT)
unnamed: C408.2, U402.29 (VCP)
unnamed: C411.2, U402.1 (CU)
unnamed: C412.2, U402.35 (CV)
unnamed: C413.2, U402.30 (CW)
unnamed: C414.1, U402.26 (CPO)
unnamed: C414.2, U402.27 (CPI)
unnamed: C420.1, J401.3, L401.2
unnamed: C421.1, J401.2, L402.2
unnamed: C422.1, J401.1, L403.2
unnamed: Q401.2, R407.1
unnamed: Q401.4, R408.1
unnamed: Q402.2, R405.1
unnamed: Q402.4, R406.1
unnamed: Q403.2, R409.1
unnamed: Q403.4, R411.1
unnamed: R403.2, U401.5 (OUT)
unnamed: R404.2, U403.5 (OUT)
SPI_MISO: U402.13 (SDO_SINGLE); also elsewhere on the board
SPI_MOSI: U402.12 (SDI); also elsewhere on the board
SPI_SCK: U402.11 (SCK_IDRV1); also elsewhere on the board
UH: U402.14 (UH); also elsewhere on the board
UL: U402.15 (UL); also elsewhere on the board
VH: U402.17 (VH); also elsewhere on the board
VL: U402.18 (VL); also elsewhere on the board
WH: U402.19 (WH); also elsewhere on the board
WL: U402.20 (WL); also elsewhere on the board

Notes on the sheet:
Driver Stage
Motor Driver
Current Sense

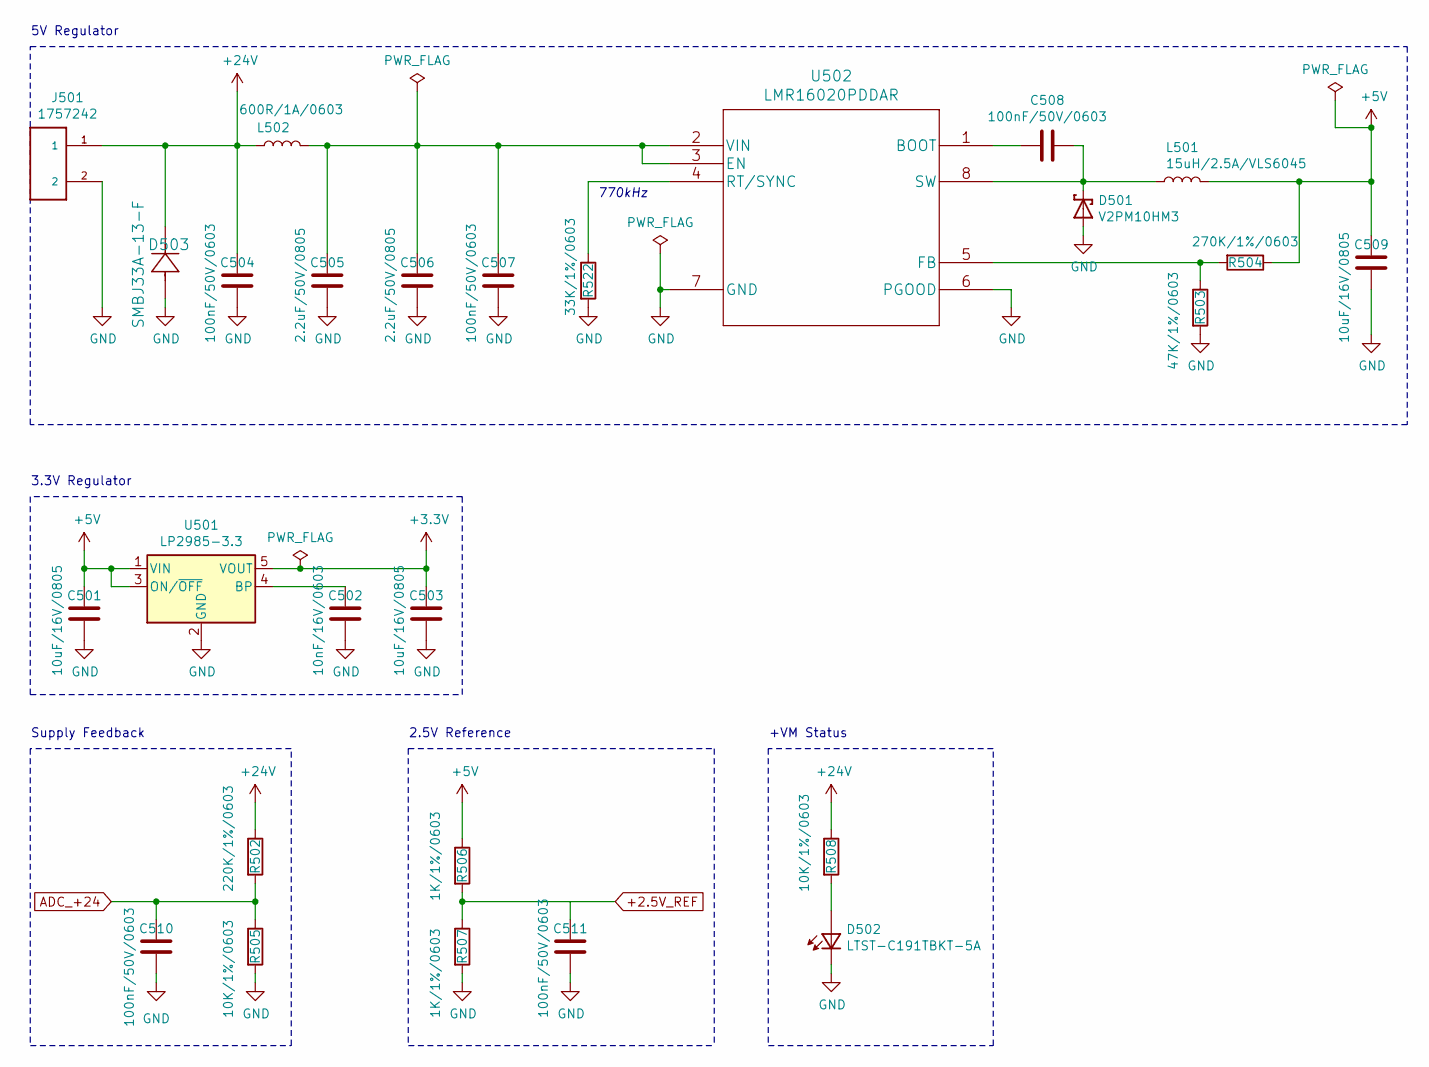
[picture p12: schematic alimentacion.sch, Spin Coater]

Parts:
C501, C503, C509: 10uF/16V/0805; C_0805_2012Metric
C502: 10nF/16V/0603; C_0603_1608Metric
C504, C507, C508, C510, C511: 100nF/50V/0603; C_0603_1608Metric
C505, C506: 2.2uF/50V/0805; C_0805_2012Metric
D501: V2PM10HM3; DIODE_MSS1P4-M3
D502: LTST-C191TBKT-5A
D503: SMBJ33A-13-F
J501: 1757242; PHOENIX_1757242
L501: 15uH/2.5A/VLS6045; INDPM6060X450N
L502: 600R/1A/0603; L_0603_1608Metric
R502: 220K/1%/0603; R_0603_1608Metric
R503: 47K/1%/0603; R_0603_1608Metric
R504: 270K/1%/0603; R_0603_1608Metric
R505, R508: 10K/1%/0603; R_0603_1608Metric
R506, R507: 1K/1%/0603; R_0603_1608Metric
R522: 33K/1%/0603; R_0603_1608Metric
U501: LP2985-3.3; SOT-23-5
U502: LMR16020PDDAR

Connections:
+2.5V_REF: C511.1, R506.2, R507.1; also elsewhere on the board
+3V3: C503.1, U501.5 (VOUT); also elsewhere on the board
+5V: C501.1, C509.1, L501.2, R504.1, R506.1, U501.1 (VIN), U501.3 (ON/~OFF~); also elsewhere on the board
+24V: C504.1, D503.1, J501.1, L502.1, R502.1, R508.1; also elsewhere on the board
ADC_+24: C510.1, R502.2, R505.1; also elsewhere on the board
GND: C501.2, C502.2, C503.2, C504.2, C505.2, C506.2, C507.2, C509.2, C510.2, C511.2, D501.2, D502.1, D503.2, J501.2, R503.2, R505.2, R507.2, R522.2, U501.2 (GND), U502.6 (PGOOD), U502.7 (GND); also elsewhere on the board
unnamed: C502.1, U501.4 (BP)
unnamed: C505.1, C506.1, C507.1, L502.2, U502.2 (VIN), U502.3 (EN)
unnamed: C508.1, D501.1, L501.1, U502.8 (SW)
unnamed: C508.2, U502.1 (BOOT)
unnamed: D502.2, R508.2
unnamed: R503.1, R504.2, U502.5 (FB)
unnamed: R522.1, U502.4 (RT/SYNC)

Notes on the sheet:
3.3V Regulator
5V Regulator
Supply Feedback
770kHz
2.5V Reference
+VM Status

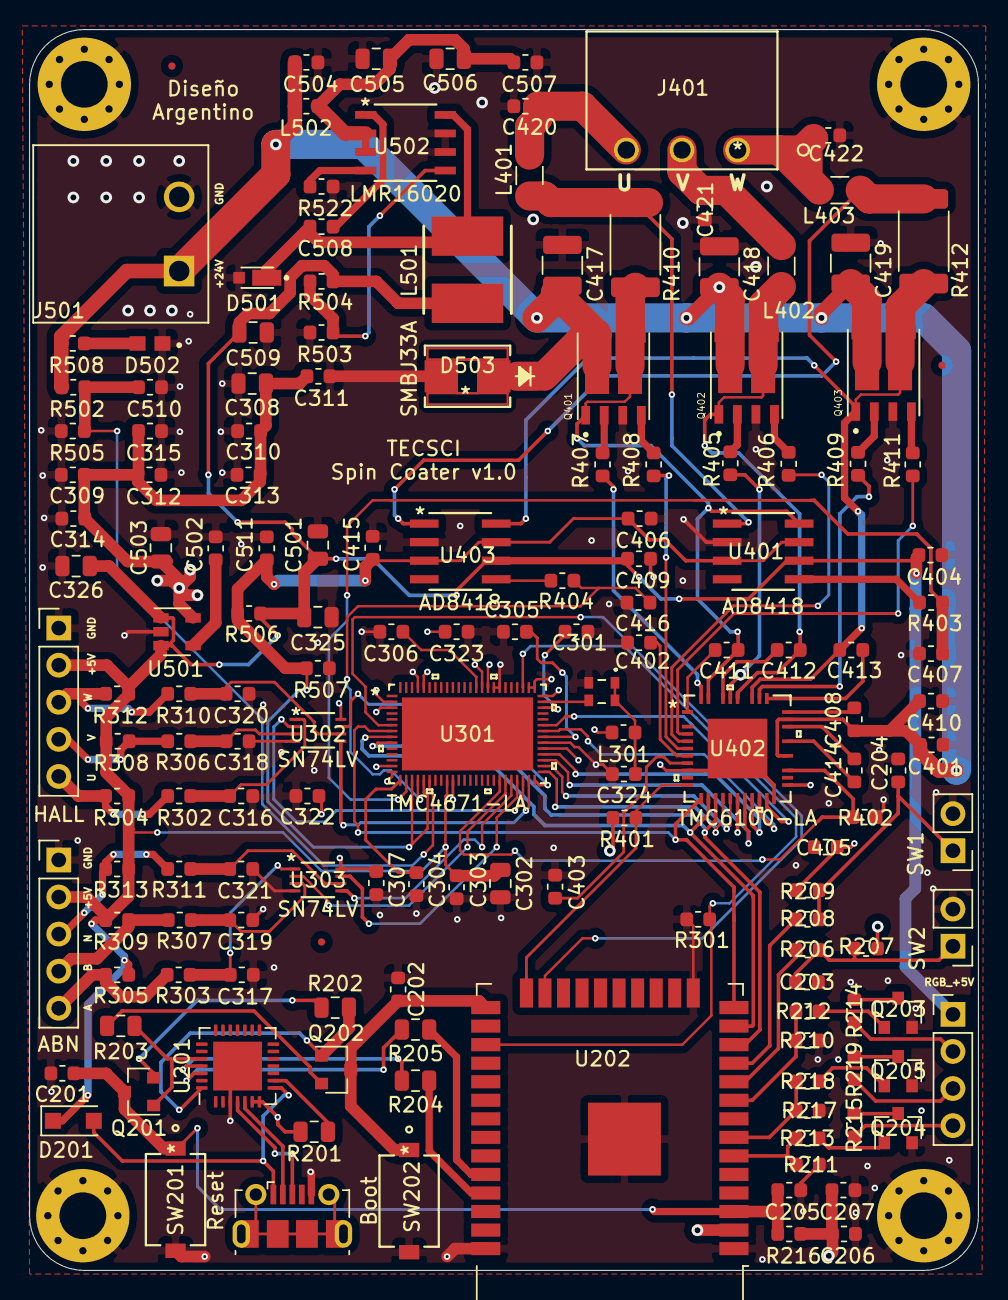
[picture p13: board spincoater.kicad_pcb from above]

Board: 4 copper layers, 65.0 x 85.0 mm, 164 parts (0 on the bottom side), 112 nets.
