martinch14/tecsci_spincoater_hardware_kicad/(commit log)

2020-06-23 primer commit
    [LTST-C191TBKT-5A--3DModel-STEP-56544.STEP, alimentacion.sch, driverMotor.sch, microcontroladorEsp.sch, motionControl.sch, spincoater.kicad_pcb, spincoater.sch, vls6045ex.step]
2020-07-11 ultima actualizacion antes de iniciar el ruteado, diseño verificado
    [alimentacion.sch, driverMotor.sch, microcontroladorEsp.sch, motionControl.sch, spincoater.sch]
2020-07-12 antes de comenzar a rutear
    [alimentacion.sch, driverMotor.sch, microcontroladorEsp.sch, spincoater.kicad_pcb]
2020-07-14 ruteado terminado revision basica- 13_07_20
    [alimentacion.sch, microcontroladorEsp.sch, spincoater.kicad_pcb]
2020-07-17 enviado a fabricar
    [alimentacion.sch, microcontroladorEsp.sch, spincoater.kicad_pcb]
2020-12-16 agrego pdf con esquematico enviado a fabricar
    [BOM_listado_Digi_Final.xlsx, spincoater_BOM_componentes.csv, spincoater_BOM_componentes.ods, spincoater_BOM_componentes.xlsx]
