martinch14/tecsci_spincoater_hardware_kicad/(notices)

Notices in the files:
driverMotor.sch:
Tecsci Technology for Science Licensed under CERN OHL v.1.2
parts and their libraries:
Copyright 2016 Accelerated Designs. All rights reserved.
